ElektraInitiative/opensesame/doc/Battery.md

# Battery Module (Bat)

Checks the battery capacity every ten minutes and outputs to Nextcloud if it falls below 80%.
