ElektraInitiative/opensesame/doc/IRTemp.md

# IR Temp

This module implements the functions "ambient temperature" and "object temperature" of the [MOD-IR-TEMP](https://www.olimex.com/Products/Modules/Sensors/MOD-IR-TEMP/open-source-hardware) sensor.

## Config

Before using this module, you need to configure it with Elektra.
The following configurations are necessary:
`[ir/enable], [ir/device], and [ir/data/interval]`.
A description of these configuration parameters can be found in the file "opensesame.spec".
