ElektraInitiative/opensesame/doc/Audio.md

# Audio Module
This module handles audio output for playing fire alarms and bell sounds.
This module can receive commands from the Module Buttons (Bell), Environment (FireAlarm), Nextcloud (FireAlarm, Bell), and Signals (FireAlarm, Bell).
