ElektraInitiative/opensesame/doc/SUMMARY.md

# Summary

[README](../README.md)

# Development

- [Requirements](Requirements.md)
- [Emulating-Olimex](Emulating-Olimex.md)
- [DevelopmentSetup.md](DevelopmentSetup.md)
- [Translations](Translations.md)
- [Benchmark](Benchmark.md)
- [Debugging](Debugging.md)
- [Troubles libmodbus](libmodbus-troubles.md)
- [Troubleshooting](Troubleshooting.md)

# Using

- [Ansible](Ansible.md)
- [Installation](Install.md)

# Modules
- [Modules Overview](Modules_Overview.md)
- [GPIO](GPIO.md)
- [I2C](I2C.md)
- [MQ135](MQ135.md)
- [Garage](Garage.md)
- [Environment](Environment.md)
- [Front door](Haustüre.md)
- [Weather station](thiesclima-weatherstation.md)
- [Opensensemap](Opensensemap.md)
- [Inverter](goodwe-inverter.md)
- [Energy](Energy.md)
- [Audio](Audio.md)
- [Battery](Battery.md)
- [IR-Temp](ModIR.md)
- [Nextcloud](Nextcloud.md)
- [Ping](Ping.md)
- [Signals](Signals.md)
- [Error-Types](Types.md)
- [Watchdog](Watchdog.md)

# Usecases

- [Low Battery Warning](usecases/assigned/low_battery_warning.md)
- [Public Publishing of Weather Data](usecases/assigned/public_publishing_of_weather_data.md)
- [Warn on Indoor Temperatures](usecases/assigned/warn_on_indoor_temperatures.md)
