ElektraInitiative/opensesame/doc/Opensensemap.md

# Opensensemap
After you've setup your account and logged in on [opensensemap.org](https://www.opensensemap.org/), you need to do following steps:

## 1. Adding a senseBox

### 1.1 Naming Your Station
Choose a distinct name for your senseBox station.
### 1.2 Specifying Exposure
Select the appropriate exposure setting: indoor, outdoor, or mobile.
### 1.3 Geographical Coordinates
Enter the latitude and longitude or pick a location on the map.
### 1.4 Hardware Configuration
Choose the "Manual configuration" option under hardware.
This option is utilized for manually configuring the weather station's sensors.

## 2. Adding Sensors

### 2.1 Sensor Icon
Choose an icon to represent the weather phenomenon you're measuring.
### 2.2 Sensor Details 
- Obtain the sensor information from the [ documentation](https://www.thiesclima.com/db/dnl/4.92xx.x0.xxx_Clima_Sensor_US_e.pdf), focusing specifically on section `8.2.1 Measurement Values (Input Register)`.
- Extract the `Parameter Name` from the provided table and enter it in the `Phenomenon` input section.
- Retrieve the `Unit` from the table and input it into the `Unit` section.
- Identify the constant name in the [source code](../src/clima_sensor_us.rs) that corresponds to the register address of the row in the table, and input it into the `Type` section.

**Example:**

| **Registeraddress** | **Parameter name** | **Unit** | **Multiplier** | **Explanation** | **Data type** |
|---|---|---|---|---|---|
| 30003 0x7533 | Average wind speed | m/s | 10 | Value / 10 (to 1 decimal place, e.g. 101=10.1m/s) | U32 |
| 35005 0x88BD | Air temperature | °C | 10 | Value / 10 (to 1 decimal place, e.g. 255=25.5°C)  | S32 |

A constant within the [source code](../src/clima_sensor_us.rs) takes the form: `const REG_AIR_TEMP: u16 = 0x88BD;`

In this illustrative scenario, the variable `REG_AIR_TEMP` represents the air temperature.
Our initial action involves transferring the parameter designation `Air temperature` to the `Phenomenon` input section. Subsequently, we proceed to incorporate `°C` from the provided table into the `Unit` input section.
Finally, the variable name `REG_AIR_TEMP` is copied into the `Type` input field.

## 3. Obtaining IDs

### 3.1 senseBox-ID
Find the senseBox-ID in the `Dashboard` section.
### 3.2 Access-Token
Locate the Access-Token in `Dashboard/EDIT/Security`.
### 3.3 Sensor-IDs
Retrieve the Sensor-IDs from `Dashboard/EDIT/Sensors`.

## 4. Configuring Opensesame for Weatherstation Usage

### 4.1 Nextcloud Setup 
Configure Nextcloud as outlined in [DevelopmentSetup.md](./DevelopmentSetup.md).
### 4.2 Weather Station Configuration
Use the following commands in your terminal to configure Opensesame for your weather station:
```bash
kdb set user:/sw/libelektra/opensesame/#0/current/weatherstation/enable "1"
kdb set user:/sw/libelektra/opensesame/#0/current/weatherstation/opensensemap/id "<opensensemap-box-id>"
kdb set user:/sw/libelektra/opensesame/#0/current/weatherstation/opensensemap/token "<opensensemap-access-token>"
```
### 4.3 Enabling Sensor Mode
Enable sensor mode by creating a sensor profile with the following settings:
```bash
kdb set user:/sw/libelektra/opensesame/#0/current/sensors/#0/loc "Weatherstation"
```

Should the process of creating this array encounter any difficulties, the alternative course of action involves manually incorporating the configuration information into the `~/.config/opensesame.toml` file:
```bash
sensors."#0".loc = "Weatherstation"
```

### 4.4 Environment Name
Set an environment name using the command:
```bash
kdb set user:/sw/libelektra/opensesame/#0/current/environment/name "<any name>"
```
