ElektraInitiative/opensesame/doc/Energy.md

# Other Elektrical Devices

Snubber needs 0.25W (0.017A)

# Mod-IO

Standby 1.3W (0.038A)

count_errors script: 2.5W (0.012A)

# Miniatur Summer 93038C212A

5V, 23 mA
