ElektraInitiative/opensesame/doc/MQ135.md

# Calibration

Actually not needed for latest approach (which only detects differences).

08-05 05:00:13
RAW Values: 105 176 205 225 153 144 56 202 50 293 389 14
RZero: 76.08 63.47 56.39 89.90 96.50 272.99 388.51 307.65 39.39 25.77 5013.32
PPM: 391.56 428.74 389.12 552.21 535.39 649.78 1517.96 641.92 1359.00 1555.39 0.47
Env1: CO₂: 400 ppm, VOC: 0 ppb
Env2: CO₂: 400 ppm, VOC: 0 ppb

# SNS-MQ135

require 5V (±0.1)
Heater Resistance: 33Ω±5%
Heating consumption less than 800mw

measured for 12x SNS-MQ135: 8.9W
0.041A (41mA)

Related humidity less than 95%Rh

analog output is 0-5V
the digital output is frequency related to the output value¹ -> wrong
You can also use this sensor to get digital output from this pin, by setting a threshold value using the potentiometer.²

Note that when sensor are power up they need about 1 minute to settle, in this time the heater heats up the sensor. 

MQ-135 detects well Isopropile alcohol, Lighter gas

    400ppm – 750ppm: Good for health
    750 ppm – 1200 ppm: Take care
    1200 ppm (and above): Harmful to health³

# Possibilities to connect

ATmega16U4: 12-channels, 10-bit ADC
MOD-IO: 4-channels, 0-3.3V 10bit, needs 3.3V shifter
MOD-IO2: 4-channels (1, 2, 3, 5), also needs 3.3V shifter

# Arduino Micro

https://store.arduino.cc/products/arduino-micro
OR
OLIMEX OLIMEXINO-328 https://www.olimex.com/Products/Duino/AVR/OLIMEXINO-328/open-source-hardware

A0 connects
0V .. 0
5V .. 1023

typical output ~40 (37-44)
breath output ~60
```bash
screen /dev/ttyACM0 9600
```

## See also

¹ https://olimex.wordpress.com/2015/05/26/experimenting-with-gas-sensors-and-arduino/

² https://components101.com/sensors/mq135-gas-sensor-for-air-quality

³ https://www.codrey.com/electronic-circuits/how-to-use-mq-135-gas-sensor/

- doesn't work well (not all MQ135 sensors are suitable)
  https://hackaday.io/project/3475-sniffing-trinket/log/12363-mq135-arduino-library
