ElektraInitiative/opensesame/doc/Modules_Overview.md

# Modules Overview
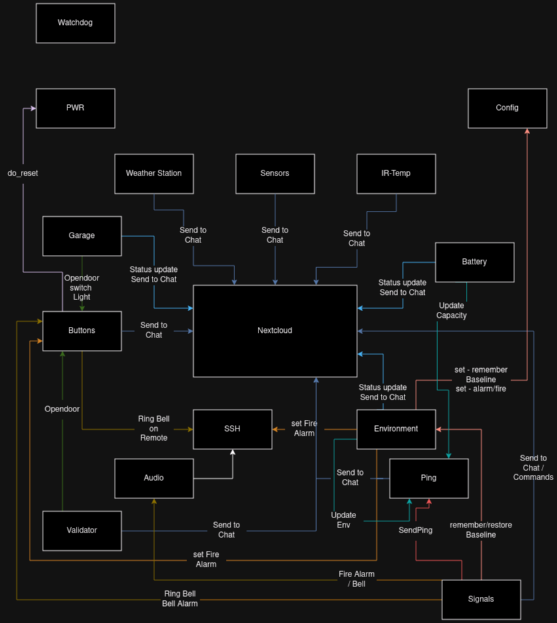
[picture p2: doc/images/information_flow_v0.8.0.png]
information_flow
