ElektraInitiative/opensesame/doc/goodwe-inverter.md

# Goodwe inverter
This documentation outlines the chosen steps for establishing communication with a goodwe-inverter. 
The hardware utilized for this communication includes an [A20-OLinuXino-LIME2](https://www.olimex.com/Products/OLinuXino/A20/A20-OLinuXino-LIME2/open-source-hardware) board with [LIME2-SHIELD](https://www.olimex.com/Products/OLinuXino/A20/LIME2-SHIELD/open-source-hardware) and a [MOD-RS485](https://www.olimex.com/Products/Modules/Interface/MOD-RS485/open-source-hardware) module. 

## important information
The `SLAVE_ID` by default `247`.
In the [doc](https://loxwiki.atlassian.net/wiki/spaces/LOX/pages/1605274474/Goodwe+GW10+ET+MODBUS+TCP+IP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) there is a list of all registers which can be read or written.

## wiring of the RS-485 connection
