ElektraInitiative/opensesame/doc/Benchmark.md

# Benchmark

## with opensesame v0.6.2

sensors: ~100ms per iteration (854ms first iteration)
haustuer: ~46ms per iteration (695ms first iteration)
garage:   ~46ms per iteration (710ms first iteration, 2620ms while compiling)
