ElektraInitiative/opensesame/(threads)

Thread 5 (2023-05-25):

opensesame.spec - configure Nextcloud

fel115, 2023-05-25:
How to setup the Nextcloud configuration in opensesame.spec.

- [x] - url
- [x] - chat; chat/licht; chat/ping
- [x] - user
- [x] - password

If these keys are not configured, this panic occurs:
`thread 'main' panicked at 'Did not find the key '/sw/libelektra/opensesame/#0/current/nextcloud/url'!', src/config.rs:121:13
stack backtrace:
   0: rust_begin_unwind
             at /rustc/84c898d65adf2f39a5a98507f1fe0ce10a2b8dbc/library/std/src/panicking.rs:579:5
   1: core::panicking::panic_fmt
             at /rustc/84c898d65adf2f39a5a98507f1fe0ce10a2b8dbc/library/core/src/panicking.rs:64:14
   2: opensesame::config::Config::get
             at ./src/config.rs:121:4
   3: opensesame::nextcloud::Nextcloud::new
             at ./src/nextcloud.rs:20:9
   4: opensesame::main
             at ./src/main.rs:187:26
   5: core::ops::function::FnOnce::call_once
             at /rustc/84c898d65adf2f39a5a98507f1fe0ce10a2b8dbc/library/core/src/ops/function.rs:250:5
note: Some details are omitted, run with `RUST_BACKTRACE=full` for a verbose backtrace.`

markus2330, 2023-05-25:
Thanks for reporting this issue! I agree this should be documented.

To get the "chat", you need to look at the URL when you are connected in the chat in the Nextcloud interface:

`https://nextcloud.markus-raab.org/nextcloud/index.php/call/<THIS IS THE TOKEN>`

markus2330, 2023-05-26:
You need the token (from the Nextcloud website) to write it in your configuration.

So first you visit https://nextcloud.markus-raab.org/nextcloud, do a login, navigate to the chat and copy the token from there to opensesame's config.

Please also document this.

fel115, 2023-05-26:
It looks like the URL doesn't exists:
`Couldn't ping 👋 Opensesame 0.7.6 init 2023-05-26T08:55:37.925376849+02:00 because https://nextcloud.markus-raab.org/ocs/v2.php/apps/spreed/api/v1/chat/vkgub94i: Client Error: 404 Not Found`

I created in Nextcloud a new conversation and then I copied the token, but for some reason the chat can't be found.

markus2330, 2023-05-28:
There is a misconfiguration in the base URL it should be https://nextcloud.markus-raab.org/nextcloud (you missed the /nextcloud). You can also easily test via curl:

`curl -sS -d "{\"token\": \"$CHAT\", \"message\": \"$*\"}" -H "Content-Type: application/json" -H "Accept: application/json" -H "OCS-APIRequest: true" -u "user:password" https://nextcloud.markus-raab.org/nextcloud/ocs/v2.php/apps/spreed/api/v1/chat/$CHAT`

Closed 2023-05-29.

Thread 6 (2023-05-25):

running opensesame causes panic with no information about the panic

fel115, 2023-05-25:
Running opensesame default, without configuring, the program abort with no further information. So there is no information about the problem.

`thread panicked while processing panic. aborting.
Abgebrochen (Speicherabzug geschrieben)`

markus2330, 2023-05-25:
Thanks for reporting the issue! Is this the problem you could solve by commenting out line 164 in src/main.rs (panic::set_hook)? Maybe we should add a configuration option for that.

fel115, 2023-05-25:
Yes. I am going to implement the CLIOptions module (https://crates.io/crates/clioptions). In case we need more CLIOption in the future.

markus2330, 2023-05-25:
Architectural changes should always be discussed in advance. We already use Elektra, which has support for command-line options: https://www.libelektra.org/tutorials/command-line-options but we shouldn't put time into this now.

Urgent now is that these beginners steps get documented, as they will be forgotten later.

Closed 2023-07-17.

Thread 7 (2023-05-25):

Remove AutoClose garage feature

markus2330, 2023-05-25:
Currently the garage door has an "automatically close later" feature by double pressing the button. This is, however, buggy, as it will also "automatically open later", which is quite surprisingly.

I think best is to completely remove that feature.

markus2330, 2023-06-06:
@fel115 this should be a quite easy feature to start with

fel115, 2023-06-09:
@markus2330  which button is pressed for this feature?

markus2330, 2023-06-09:
Everything related to GarageChange::AutoClose (double click on *_UNTEN*)

fel115, 2023-06-13:
Whats the difference between `taster_tor_oben` and `taster_tor_unten`, are these two taster, one for closing and the other for opening the door? And which would be for which case?

markus2330, 2023-06-14:
> Whats the difference between taster_tor_oben and taster_tor_unten, are these two taster, one for closing and the other for opening the door? And which would be for which case?

No, one of them is for lights, the other for the garage door. So there is only one button relevant for the garage door.

> So the other AutoClose feature is still needed, to close the door immediately?

No, the AutoClose feature can be removed completely. (AutoClose === double press garage feature) I renamed the issue to hopefully bring in more clarity.

> But if you click the button twice, the door is going to be closed 2 min after the button clicks.

This is exactly the behavior that should be removed. In the code it is called "AutoClose".

Please add test cases for the other features (normal opening and closing of garage door).

Closed 2023-07-17.

Thread 8 (2023-05-26):

simulate i2c device

fel115, 2023-05-26:
So I only need the Token ? Do I need to configure my nextcloud account?
Now I am getting this Error:

`Couldn't ping 👋 Opensesame 0.7.6 init 2023-05-25T19:44:20.353056793+02:00 because https://nextcloud.markus-raab.org/ocs/v2.php/apps/spreed/api/v1/chat/<THIS IS THE TOKEN>: Client Error: 404 Not Found
thread 'main' panicked at 'called `Result::unwrap()` on an `Err` value: Io(Os { code: 13, kind: PermissionDenied, message: "Keine Berechtigung" })', src/buttons.rs:132:65
stack backtrace:
   0: rust_begin_unwind
             at /rustc/84c898d65adf2f39a5a98507f1fe0ce10a2b8dbc/library/std/src/panicking.rs:579:5
   1: core::panicking::panic_fmt
             at /rustc/84c898d65adf2f39a5a98507f1fe0ce10a2b8dbc/library/core/src/panicking.rs:64:14
   2: core::result::unwrap_failed
             at /rustc/84c898d65adf2f39a5a98507f1fe0ce10a2b8dbc/library/core/src/result.rs:1750:5
   3: opensesame::buttons::Buttons::new
   4: opensesame::main
note: Some details are omitted, run with `RUST_BACKTRACE=full` for a verbose backtrace.`

_Originally posted by @fel115 in https://github.com/ElektraInitiative/opensesame/issues/5#issuecomment-1563300690_
    
As I backtraced this panic I recognised , that it isn't caused by Nextcloud instead it is caused by the button.rs LinuxI2CDevice. I think its because my devl-env has no `/dev/i2c-2` device. This could be solved by simulating the i2c device. Online I found the i2c-stub (https://www.kernel.org/doc/html/latest/i2c/i2c-stub.html), which cloud be the perfect tool.

markus2330, 2023-05-27:
Alternatively, and probably better for tests, is that you use the mocking from the i2c lib https://docs.rs/i2cdev/0.5.0/i2cdev/mock/struct.MockI2CDevice.html

But I wouldn't do that now, it is quite challenging from Rust point of view.

Closed 2023-10-15.

Thread 11 (2023-06-04):

Running opensesame against current development version of Elektra panics

atmaxinger, 2023-06-04:
So I have been trying to get opensesame running on the Olimex image.
I've compiled and installed the current `recording` branch of Elektra.

When I perform `cargo run` on opensesame, the following output is issued:

```
thread 'main' panicked at 'Set config failed: Sorry, module  issued error :
: ', src/config.rs:29:17
```

This is the backtrace:
```
stack backtrace:
   0: rust_begin_unwind
             at /rustc/90c541806f23a127002de5b4038be731ba1458ca/library/std/src/panicking.rs:578:5
   1: core::panicking::panic_fmt
             at /rustc/90c541806f23a127002de5b4038be731ba1458ca/library/core/src/panicking.rs:67:14
   2: opensesame::config::Config::sync
             at ./src/config.rs:29:5
   3: opensesame::config::Config::new
             at ./src/config.rs:20:3
   4: opensesame::main
             at ./src/main.rs:141:27
   5: core::ops::function::FnOnce::call_once
             at /rustc/90c541806f23a127002de5b4038be731ba1458ca/library/core/src/ops/function.rs:250:5
```

Any help on how to debug/solve this would be highly appreciated.

markus2330, 2023-06-04:
Did you already see https://github.com/ElektraInitiative/opensesame/pull/10/files?

Maybe @fel115 can help out, he went through similar problems recently.

Btw. as you see the error message is completely unhelpful, the parentKey is missing, and it actually should be **G**et config failed. To fix this first will probably help.

atmaxinger, 2023-06-05:
Yes, executing the postinst script manually solved this specific issue yesterday. However, there seems to be a bug somewhere, because I actually installed the `.deb` file built with `cargo deb`, and the script complains that it can't find the `kdb` executable. I think that might be caused by the `kdb` executable being installed in `/usr/local/bin` instead of `/usr/bin`.

Anyhow, executing the script `/var/lib/dpkg/info/opensesame.postinst` manually fixes this.

atmaxinger, 2023-06-05:
> (e.g. as Debian packages)

I have installed Elektra as Debian packages, I created them with the `make package` command. I'm not sure why it wants to install them to `/usr/local`.

markus2330, 2023-06-05:
It's the default from CMake, you need to set CMAKE_INSTALL_PREFIX=/usr to get proper packages.

markus2330, 2023-07-17:
Is this fixed now?

Thread 16 (2023-06-07):

TASTER_INNEN might lead to "Pressed 11" error

markus2330, 2023-06-07:
Probably due to "too fast release speed" of a switch, TASTER_INNEN might lead to "Pressed 11" errors.

```
src/main.rs:479: 🔘 Pressed 11 (bin: 1011)
```

Could be either a software bug (that handle src/buttons.rs 271 does not cope with a too fast state change) or a wrong handling of debouncing.

markus2330, 2023-06-07:
This problem is probably now much more apparent due to lower i2c speed introduced in 7018655756d7f1f1fedcff3ae2e3fcf581360f38

(But I don't think it was introduced by it.)

fel115, 2023-06-23:
How does `epins2.unwrap()` behave when a button is pressed? Does it return zero or one for the pressed button? Additionally, what is the purpose of `PINS2_INIT`? Does it activate the `LED_LIGHT` and `LED_BELL`?

Regarding `line 312` of the button.rs file, the comment states that pressed buttons are considered logical 0. Could you clarify whether this refers to the set pins or the return value? Why is it necessary for `pins2` to be smaller than the old `pins2` when the pressed button is zero?

fel115, 2023-06-26:
Ok so, the first 4 bits of the 8 bits of `pins2` indicate which button is pressed, and for a pressed button a bit is set to `0`.
I understand it now. Thank you!

markus2330, 2023-09-07:
This is a duplicate of #41

Closed 2023-09-07.

Thread 17 (2023-06-07):

i2c_2_clock_freq_overlay.dtbo not part of olinuxino-overlay

markus2330, 2023-06-07:
if `i2c_2_clock_freq_overlay.dtbo` is present in `/usr/lib/olinuxino-overlays/sun7i-a20` you get following error:

```
sudo olinuxino-overlay
`Error at 'compatible': FDT_ERR_NOTFOUND`
```
and `i2c_2_clock_freq_overlay.dtbo` cannot be selected in the list.

fel115, 2023-06-07:
I added the compatible and description attribute to the devicetree overlay, should I also add the sourcecode of the devicetree overlay to the project? If so in which folder should I add the sourcecode file?

markus2330, 2023-06-07:
Good point, yes of course, the source code should be added.

> If so in which folder should I add the sourcecode file?

Depends on number of files/size. If it is only one file, probably directly next to the binary file.

markus2330, 2023-06-07:
It is still not listed in `sudo olinuxino-overlay`, probably it filters based on the name (but I don't know).

fel115, 2023-06-09:
I analysed the `olinuxino-overlay`-script and I think the problem is, because I added in the following line a whitespace between the comma and sun7i-a20.
Changing this `compatible = "allwinner, sun7i-a20";` to `compatible = "allwinner,sun7i-a20";` cloud solve this issue.

fel115, 2023-07-17:
This issue is closed with the PR #29

Closed 2023-07-17.

Thread 28 (2023-07-17):

cli options for running opensesame

fel115, 2023-07-17:
Add command-line options to the OpenSesame project to allow disabling specific sections of the main program, such as the `panic::set_hook function`, which currently lacks informative panic details.

This idea of cli options was mentioned in this issue #6.

markus2330, 2023-07-17:
Better we talk about this. In any case it is not urgent, you can simply use normal Elektra config and `kdb set ...` to change config.

fel115, 2023-07-18:
Yes, I created this issue because I closed issue #6, so this information doesn't get lost.

Closed 2023-10-15.

Thread 32 (2023-07-18):

dependencies of opensesame package

markus2330, 2023-07-18:
What I did with the deb found in https://build.libelektra.org/blue/organizations/jenkins/opensesame/detail/PR-25/39/artifacts/

```
echo "deb [trusted=yes] https://thesis.maxirlinger.at/repo/ armhf/" > /etc/apt/sources.list.d/elektra-armhf.list && apt-get update
apt-get install -y --allow-unauthenticated libelektra-dev:armhf elektra-bin:armhf
dpkg -i opensesame_0.7.7_armhf.deb
```

What happened:
```
(Reading database ... 36751 files and directories currently installed.)
Preparing to unpack opensesame_0.7.7_armhf.deb ...
Unpacking opensesame (0.7.7) ...
Setting up opensesame (0.7.7) ...
Mount configuration
The command kdb spec-mount terminated unsuccessfully with the info:
No plugin that provides metadata check/length/max could be found
Please report the issue at https://issues.libelektra.org/
Mount state
Created symlink /etc/systemd/system/multi-user.target.wants/opensesame.service → /lib/systemd/system/opensesame.service.
```

I think we need some additional dependency next to elektra-bin in opensesame's package.

atmaxinger, 2023-07-18:
It seems to work with those new dependencies in PR #25

markus2330, 2023-07-18:
@atmaxinger thank you :heart:! Can we maybe move the length plugin to non-experimental for 0.11?

Closed 2023-07-18.

Thread 35 (2023-07-18):

Cargo test inside jenkins image

4ydan, 2023-07-18:
Cargo test inside the image used in jenkins would currently fail, due to missing ENV variables.
#25

Adding this to the Dockerfile or as env should fix it. Testet locally.

```
export PKG_CONFIG_PATH="/usr/lib/arm-linux-gnueabihf/pkgconfig"
export PKG_CONFIG_ALLOW_CROSS="true"
```

Closed 2023-08-09.

Thread 40 (2023-07-21):

PWR+watchdog might cause endless reboot loop

markus2330, 2023-07-21:
When pwr and watchdog is enabled, olimex might go in an endless reboot loop writing in the ping chat:

```
👋 Opensesame 0.7.7 init 20.07.2023 10:50:06
👋 PWR_SWITCH ausgeschalten
👋 Opensesame 0.7.7 init 20.07.2023 10:51:01
👋 PWR_SWITCH ausgeschalten
👋 Opensesame 0.7.7 init 20.07.2023 10:51:10
👋 PWR_SWITCH ausgeschalten
```

config:

```toml
debug.backtrace = "full"
debug.ping.enable = "1"
debug.ping.timeout = 24

pwr.enable = "1"
watchdog.enable = "1"
garage.enable = "0"
bell.enable = "1"
```

Workaorund: disable watchdog

markus2330, 2023-10-15:
Probably fixed now with 0.8, I'll reopen if it occurs again.

Closed 2023-10-15.

Thread 41 (2023-07-21):

ignore 11 press events

markus2330, 2023-07-21:
Due to electrical charges, e.g. during thunderstorms, single button presses may occur. Particularly, I noticed the button press event `11`:

```
Ein unbehebbarer Fehler ist bei src/main.rs:479: 🔘 Pressed 11 ... passiert
```

and:

```
Timeout mit Sequenz [0, 15, 0, 15, 0, 15]
```

For now this issue is only to collect such occurrences.

Maybe find an easy way to suppress such events.

Closed 2023-12-06.

Thread 42 (2023-07-22):

No metadata "mountpoint"

4ydan, 2023-07-22:
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
It's me again with another error. Not sure if I did something or something happened, so I will ask quick. It's the same setup as in #30, now I get this error when I want to run `postinst`.

markus2330, 2023-07-23:
Thx for asking. Most probably it somehow didn't mount the right file. What does `kdb mount` or `kdb file spec:/sw/libelektra/opensesame/#0/current` say?

fel115, 2023-07-24:
I think I had the same problem. And for solving the problem I executed `debian/postrm` and then again `debian/postinst`.

4ydan, 2023-07-24:
> What does `kdb mount`
```
[2023-07-24T19:37:11.798Z] + kdb mount
```
> or `kdb file spec:/sw/libelektra/opensesame/#0/current` say?
```
[2023-07-24T19:37:12.459Z] + kdb file spec:/sw/libelektra/opensesame/#0/current
[2023-07-24T19:37:12.459Z] /usr/share/elektra/specification/default.ecf
```

from [this](https://build.libelektra.org/blue/organizations/jenkins/opensesame/detail/PR-38/38/pipeline) pipeline inside stage `Test`

fel115, 2023-07-25:
I have no clue about the cause of this failure. However, based on the pipeline, we should modify the exit codes of the scripts to determine whether the job was successfully mounted or not.

markus2330, 2023-07-25:
> /usr/share/elektra/specification/default.ecf

`spec:/sw/libelektra/opensesame/#0/current` was not mounted at all

I'll have a closer look after the PermaplanT release.

markus2330, 2023-07-25:
> we should modify the exit codes of the scripts to determine whether the job was successfully mounted or not.

And also add a diagnostic `kdb mount` at the end.

markus2330, 2023-07-26:
"No metadata mountpoint" basically means that the whole spec file was not mounted correctly at its place.
(It is easy to see that files/opensesame.spec has a mountpoint at the very top, line 15).

I can reproduce, if I simply execute `./debian/postinst` in the `opensesame` folder I also get the same error. But if I enter the `debian` folder and execute `./postinst` it works for me. Maybe this is the problem?

Imho the correct way is anyway to install the package. Executing `./postinst` by hand is imho only a workaround for development.

fel115, 2023-07-27:
Maybe we could change the `postinst` script to be able to execute from any directory.

markus2330, 2023-07-27:
I don't think it is needed, as it is only a dev tool. Simply documenting how to use it in #10 imho should be enough.

Closed 2023-08-09.

Thread 47 (2023-07-29):

create circuit diagram

fel115, 2023-07-29:
Having a circuit diagram would make setting up the whole Opensesame system way easier. With a picture showing all the connections, you can put together the hardware setup much faster. The circuit diagram gives you a visual guide to understand how everything is connected, making the assembly process quicker and simpler. It's like a handy reference to ensure you're hooking up the hardware correctly, so you can avoid mistakes and get Opensesame up and running without a hitch.

fel115, 2023-07-29:
@markus2330, perhaps you could provide me with some pictures of the A20-Lime2 board and the MOD-IO2. With that, I can create the diagram.

markus2330, 2023-07-29:
This is a great idea and I would like to have it. Unfortunately, it is out of scope for the current work, we are already quite behind the schedule to implement everything in TODO. This is, however, definitely within scope for Netidee!

Closed 2023-10-19.

Thread 51 (2023-08-03):

I2C Communication to Buttons does not work: Nix(ENXIO)

fel115, 2023-08-03:
Testing opensesame on a board without the MOD-IO2 module causes the following Error.

```bash
thread 'main' panicked at 'I2C Communication to Buttons does not work: Nix(ENXIO)', src/buttons.rs:142:14
stack backtrace:
   0: rust_begin_unwind
             at /rustc/d5a82bbd26e1ad8b7401f6a718a9c57c96905483/library/std/src/panicking.rs:575:5
   1: core::panicking::panic_fmt
             at /rustc/d5a82bbd26e1ad8b7401f6a718a9c57c96905483/library/core/src/panicking.rs:64:14
   2: core::result::unwrap_failed
             at /rustc/d5a82bbd26e1ad8b7401f6a718a9c57c96905483/library/core/src/result.rs:1791:5
   3: core::result::Result<T,E>::expect
             at /rustc/d5a82bbd26e1ad8b7401f6a718a9c57c96905483/library/core/src/result.rs:1070:23
   4: opensesame::buttons::Buttons::init
             at ./src/buttons.rs:140:3
   5: opensesame::buttons::Buttons::new
             at ./src/buttons.rs:135:3
   6: opensesame::main
             at ./src/main.rs:296:20
   7: core::ops::function::FnOnce::call_once
             at /rustc/d5a82bbd26e1ad8b7401f6a718a9c57c96905483/library/core/src/ops/function.rs:507:5
note: Some details are omitted, run with `RUST_BACKTRACE=full` for a verbose backtrace.
```
Maybe we should set some variables to enable and disable modules in opensesame. As I have seen `buttons` is widely used in the source, so it's hard to disable it without causing other errors.

markus2330, 2023-08-03:
It is already possible to disable some modules. Disabling the buttons is currently only possible by enabling sensors, which --- I agree --- is a weird hack. When we introduce more and more Tokio, we can also create smaller modules.

But: we should keep the current uniform way of using Elektra's configs `<module>/enable` to enable modules. We can use environment variables and command-line arguments also via Elektra, maybe @flo91 will work on that.  #28

markus2330, 2023-08-04:
> How do I enable sensors?

spec and code should give such answers :wink:

fel115, 2023-08-04:
> > How do I enable sensors?
>
> spec and code should give such answers 😉

Ahhh eh

markus2330, 2023-08-04:
I created /home/olimex/.config/opensesame.toml using Ansible, can you please add the additional config needed for the weatherstation?  (sensor mode is already active)

markus2330, 2023-08-04:
I get this error above even if `user:/sw/libelektra/opensesame/#0/current/sensors/#0/loc` is present.

Seems like there is some regression.

markus2330, 2023-10-15:
Seems to be fixed now.

Closed 2023-10-15.

Thread 58 (2023-08-15):

Implementation of MOD-BME280

fel115, 2023-08-15:
The aim of these issues is to exchange the [MOD-ENV](https://www.olimex.com/Products/Modules/Sensors/MOD-ENV/open-source-hardware) module with [MOD-BME280](https://www.olimex.com/Products/Modules/Sensors/MOD-BME280/open-source-hardware). The difference between these two modules is, that the [MOD-ENV](https://www.olimex.com/Products/Modules/Sensors/MOD-ENV/open-source-hardware) is also able to measure the air quality.

fel115, 2023-08-15:
@markus2330, based on my understanding, it seems that we need to modify the 'environment.rs' file to enable configuration specifically for using theMOD- BME280. This adjustment is necessary because the MOD-ENV includes both the BME280 and an additional CO2 sensor.

fel115, 2023-08-15:
@markus2330 what's the difference between "environment.rs" and "sensors.rs"? What sensors are connected over the '/dev/ttyACM0'? Is there external hardware with sensors connected which are sending the sensor data over this serial connection?

Would it be better to create a handler in which it is possible to enable env-sensors and the other sensors explicitly?

fel115, 2023-08-16:
OK, then I would create a new Module for MOD-BME and the MOD-IR-TEMP for returning temperature, pressure, and humidity. So the new module can be used in the main loop if it is configured.

Closed 2023-12-04.

Thread 62 (2023-08-16):

Implementation of MOD-IR-TEMP in new module

fel115, 2023-08-16:
**Create a new Module with the following functions**
- [x] read object temperature
- [x] read ambient temperature

markus2330, 2023-08-21:
Thank you for creating the issue! I don't think we actually need the raw IR measurement.

Closed 2023-09-04.

Thread 64 (2023-08-18):

spelling fixes

markus2330, 2023-08-18:
Let us use some spell checker. In PermaplanT we have in .pre-commit-config.yaml:

```
  - repo: https://github.com/codespell-project/codespell
    rev: v2.2.4
    hooks:
      - id: codespell
        # Scan all .md files, exclude folders /meetings & /reports.
        files: ^(?!.*\/(meetings|reports)\/).*\.md$
        args: [-L crate]
        stages: [manual]
```

markus2330, 2023-10-15:
please do at least one manual run

Closed 2023-10-20.

Thread 70 (2023-08-21):

Env - Configurable corrections on Temperature

fel115, 2023-08-21:
@markus2330 what is meant by this task? Which correction? Something like a closed-loop controller?

markus2330, 2023-08-22:
It is simply a correction value to be added/removed to adjust/calibrate the temperature. The user only should see the corrected value.

fel115, 2023-08-22:
So the configurable correction could be `-0.4°C` and the sensor temp `26.8°C`, then should the user see `26.4°C` as a result?

markus2330, 2023-08-22:
Exactly. This is useful as the MOD-ENV are quite inaccurate. I didn't check MOD-IR yet (compare with high-precision thermometer) but probably something similar is useful there, too.

fel115, 2023-08-23:
According to the [data-sheet](https://www.olimex.com/Products/Modules/Sensors/MOD-IR-TEMP/resources/MLX90614_rev001.pdf) the MOD-IR has a high accuracy. `High accuracy of 0.5°C over wide temperature
range (0..+50°C for both Ta and To)`.

Should I create a new PR for this issue, after #63 is merged?

markus2330, 2023-08-24:
Not high-prior, let us do the refactoring first.

markus2330, 2023-08-24:
Not high-prior, let us do the refactoring first.

markus2330, 2023-10-14:
@fel115 do you already have a fix for this?

fel115, 2023-10-18:
Not implemented now

Closed 2023-10-19.

Thread 71 (2023-08-21):

Env - warn on fast raising values, next to MQ135 (temperature, CO2, VOC, Pressure)

fel115, 2023-08-21:
@markus2330 How is the MQ135 connected via the `/dev/ttyACM0`? And where should this function be implemented, in the environment.rs or mod_ir_temp.rs?

markus2330, 2023-08-22:
For MQ135 it is already implemented, see src/sensors.rs line 154. The idea is to do the same for mod-env and mod-ir.

The idea is to warn on very fast changing values, which could be caused by direct sunshine or also fire.

fel115, 2023-08-23:
Ok, this needs to be implemented for MOD-IR-TEMP and MOD-ENV. Is it a requirement to use the Exponential Moving Average?

markus2330, 2023-10-14:
@fel115 do you already have a fix for this?

fel115, 2023-10-18:
Not implemented now

Closed 2023-10-19.

Thread 72 (2023-08-21):

Env - temperature alarm e.g. 50° (check max temp from sensor) and warning e.g. 28° (window left open)

fel115, 2023-08-21:
@markus2330 Should this function be set in the main.rs? Is the `window left open` function already implemented?

fel115, 2023-08-21:
removed from TODO in PR #65

Closed 2023-08-21.

Thread 74 (2023-08-23):

Architectural changes: Tokio + Modules

horenso, 2023-08-23:
This issue is to keep track of the architectual changes in main and the restructure of the system into "modules", which work independenly of each other.

@fel115 and myself identified the following functunality (work in progress, I'm just dumping them here)

- [ ] Config (libelektra)
- [ ] Nextcloud (bidirectonal status and commands, reusing http client/connections)
- [ ] Weather Station
- [ ] Sensor (has fire alarm)
- [ ] Buttons (MOD-IO2)
- [ ] Validator
- [ ] Garage / Door / Light
- [ ] Bat (battery supply and warning about battery mode)
- [ ] Watchdog
- [ ] PWR
- [ ] Environment (MOD-ENV)
- [ ] SSH / Other way of distributed communication

At the moment, there are two independet loops in main, "sensor mode" and "normal mode". To reason about the current architecture more clearly we refactored it (https://github.com/horenso/opensesame/blob/refactor_main/src/main.rs) into diffenent methods, without changing the semantics. This is helpful to see what parts are actually used in which loop.

The next step is to identify all blocking calls and research alternatives. For sure, all file operations (like `lines()`) must be replaced with async methods (like `tokio::fs`).

Modules can be enabled/disabled. Some things above (like config) are global whereas Nextcloud, Button and Sensors should become modules. More details about the exact interfaces follow.

markus2330, 2023-08-24:
Thank you for creating this issue!

> following functunality

I added `-  [ ]` so that you can track progress by clicking on the items. I also prioritized them, in which order I would like to test (weather station + sensors first).

> (MOD-IO2, has fire alarm)

What do you mean with that? Sensor does not need MOD-IO2.

> This is helpful to see what parts are actually used in which loop.

I am not sure if we are on the same page: these two loops are arbitrary and don't have any relevance. Any module should work together with any other module, there shouldn't be a normal or sensor mode. Sensors should be a normal module like any other.

> The next step is to identify all blocking calls and research alternatives.

First the interfaces.

It is important that we have intermediate steps every day, so that we soon can start testing. Let us first get weather station+sensors running on the new architecture (the file writes done in the sensor loop can be dropped, they are not important).

> Modules can be enabled/disabled.

:+1:

> Some things above (like config) are global whereas Nextcloud, Button and Sensors should become modules.

Nextcloud in general also needs to be global. Ping could be a module.

> More details about the exact interfaces follow.

Looking forward to :rocket:

horenso, 2023-08-27:
Thanks for the comments!

> What do you mean with that? Sensor does not need MOD-IO2.

What is the MOD-IO2 needed for? I don't have a clear picture about all the hardware involved yet.

> I am not sure if we are on the same page: these two loops are arbitrary and don't have any relevance. Any module should work together with any other module, there shouldn't be a normal or sensor mode. Sensors should be a normal module like any other.

We're on the same page, this refactor was just to assess how the program works right now. Of course there will only be one event loop with different capabilities, that can be enabled and disabled.

> It is important that we have intermediate steps every day, so that we soon can start testing. Let us first get weather station+sensors running on the new architecture (the file writes done in the sensor loop can be dropped, they are not important).

Good idea. I'll make a PR soon with the first step.

markus2330, 2023-08-27:
> What is the MOD-IO2 needed for?

Currently only for the "buttons" module.

>  I'll make a PR soon with the first step.

:rocket:

markus2330, 2023-10-15:
All seems to be done now.

Closed 2023-10-15.

Thread 77 (2023-08-29):

Docu: Async Architecture and Interfaces

fel115, 2023-08-29:
# Async Architecture
The following modules can be disabled through elektra config.
- bat.rs
- buttons.rs + garage.rs
- clima_sensor_us.rs
- environment.rs
- garage.rs
- mod_ir_temp.rs
- pwr.rs
- sensors.rs
- ssh.rs
- validator.rs
- watchdog.rs

`config.rs` and `nextcloud.rs` are the minimal modules, which are needed for running Opensesame. Or should it be possible to replace `nextcloud` with an std-output?

# Module Interfaces
## 1. Enable checked by modules
### 1.1. new(config) -> Self;
This function returns a new object of the struct. According to the config in elektra it returns an default object or a object with all data like 'libmodbus' connection, 'i2c' connection.
### 1.2. All pub functions need to check if this object is enabled or disabled, with a variable in the struct.
If a module is disabled it returns an error code that indicates that the module is disabled.
## 2. Enable checked by async loop
### 2.1. new(config) -> Self; and new_default() -> Self;
These two functions are needed because if a module is disabled the main loop calls `new_default() -> Self` to get a default object, so the variable in `main` is not uninitialized. The variable is overwritten with ` new(config) -> Self` if the module is enabled. So it would be possible to enable and disable modules during runtime.
### 2.2 Main function
In the `main`, it would be only if conditions for every module.

horenso, 2023-08-29:
2.1. Why don't we keep a collection of modules (Like a `Vec<dyn Module>` or something like that)? That seems better than having dummy objects.

I imagine it something like this:

```rust
use tokio::io::{self, AsyncBufReadExt};

pub async fn read_device_file(device: &str) {
    let file = tokio::fs::File::open(device).await.unwrap();
    let reader = io::BufReader::new(file);

    let mut lines = reader.lines();
    while let Some(line) = lines.next_line().await.unwrap() {
        println!("Read from device: {}", line);
    }
}
```

and then in main:

```rust
#[tokio::main]
async fn main() {
    ...

    if condition_1 {
        tokio::spawn(module1::read_device_file("/dev/test1"));
    }

    if condition_2 {
        tokio::spawn(module1::read_device_file("/dev/test2"));
    }

    loop {
        // here we listen to config/nextcloud changes
    }
}
```

Note that we don't have to have a dynamic approach, meaning that you cannot enable a disabled module without restarting.

horenso, 2023-08-29:
I think the two challenges are:
1. How can we have clean error handling?
2. How can we share a module like Nextcloud? I suppose we need to work with `Mutex`s so that Nextcloud should ask a `state` variable that is owned by the module.

fel115, 2023-08-29:
> 1\. How can we have clean error handling?

I thought about something like that:
```rust
pub enum Error<E> {
    I2C(E),
    MODBUS(E),
    DISABLED,
    ...
}
```
> 2\. How can we share a module like Nextcloud? I suppose we need to work with `Mutex`s so that Nextcloud should ask a `state` variable that is owned by the module.

Do we need to share the Nextcloud module? We could create a Nextcloud object for every module or is that problematic?

3. What we also need to think of is, that many modules use timeouts that depend on the main-loop, because the main-loop sleeps for 10ms every duration. So if a timeout is set to `1000` it means 10 seconds. If we don't have any sleep we need to manage this differently.

markus2330, 2023-08-29:
Next steps:

- create a PR where the interface is described in (pseudo) Rust code.
- ask further questions here as needed

> config.rs and nextcloud.rs are the minimal modules, which are needed for running Opensesame. Or should it be possible to replace nextcloud with an std-output?

If nextcloud fails to send, there is a message to stderr anyway. Having exchangeable modules for different chats is out-of-scope.

>new(config) -> Self;

We need a description in which situations it is allowed to fail. I think it should always succeed, even if it is totally broken. Then the object simply disables itself.

> If a module is disabled it returns an error code that indicates that the module is disabled.

How does it return the error code?

> These two functions are needed because if a module is disabled the main loop calls new_default() -> Self to get a default object, so the variable in main is not uninitialized.

I think it is more pretty if all of this happens within `new(config) -> Self`? So if it is disabled, a default Self doing nothing is returned.

> In the main, it would be only if conditions for every module.

I don't understand the sentence.

> With Tokio we can also just spawn threads for each module.

We should avoid that. Spawning a thread for a module is only last resort if everything else fails. Functional better is an architecture where tasks are delegated to a thread pool  (needing less resources as it spawns less threads, ideally only a thread per CPU).

> Note that we don't have to have a dynamic approach, meaning that you cannot enable a disabled module without restarting.

What can happen is that at runtime a module fails and it needs to be disabled as the error is permanent. (To not get errors for each time calling `handle()`.)

> How can we have clean error handling?

Yes, this is an important topic.

> How can we share a module like Nextcloud? I suppose we need to work with Mutexs so that Nextcloud should ask a state variable that is owned by the module.

The imho prettiest solution is that modules provide means to tell that something should be communicated and main or a dispatcher forwards this information to Nextcloud. Then the modules would not know anything about Nextcloud. This is also currently the case.

Easier/more flexible for modules is probably what you suggest. I am okay with both.

The big question is how you want to solve the incoming chat messages.

> Do we need to share the Nextcloud module? We could create a Nextcloud object for every module or is that problematic?

Yes, it is problematic, as then you would have N connections to Nextcloud. Ideally you would only have one (or one per thread if you don't want mutex at all).

>  What we also need to think of is, that many modules use timeouts that depend on the main-loop, because the main-loop sleeps for 10ms every duration. So if a timeout is set to 1000 it means 10 seconds.

This 10ms raster was only a hack for not having proper scheduling of tasks. It is better if either

- we hardcode how often which module gets called. So if the module only needs to be called every second, it also only gets called every second (and not 100 times, ignoring 99 times).
- modules tell when they should be called again (a bit more flexible but might be also more complicated. The current code does not necessarily need it. In some cases it would have been nice to have, e.g. for buttons you typically want every 10ms but for relay switching 10ms is too fast).

fel115, 2023-08-29:
Issue # #74

markus2330, 2023-08-30:
> But how does the calling function then know, what has happened? So the user would think the module is loaded but it isn't.

I thought that there is some `status()` function that tells the framework if a module is disabled.

> I meant that only the main loop checks if an object of the modules should be created.

I think it is simpler if modules decide this internally. There might be more tricky situations of disabling which imho belong to the module and not to main.

> So do you mean, that we have a thread per module, but the module-threads are added to a pool, where they are executed one by one?

No, there is only the main thread and a thread pool, empty when starting. The main thread is doing the tokio mainloop and the thread pool executes longer tasks to never block the mainloop (if needed). The modules don't have threads on their own but their tasks get assigned to any of the threads in the pool.

Probably an existing thread pool implementation should be used, in a quick search I found:

- https://docs.rs/rayon/1.3.0/rayon/struct.ThreadPool.html
- https://docs.rs/tokio-threadpool/latest/tokio_threadpool/

@fel115 please have a better look at options available, write a decision about that. You might be able to use this research in your thesis. E.g. see https://www.usenix.org/conference/atc20/presentation/boucher (only meant as hint for your thesis, I don't propose that we use this in Opensesame).

>  Is it possible for the modules to add their messages to a queue? So the modules can't overwrite the content of other modules? Or doesn't it work because of the borrowing of the nextcloud object?

Is this question to me or @horenso? What did you find out so far?

> So I think it would be easy to ask the server for new messages every few times. And for that async isn't necessary. You only need to save the ID of the last read message and then you are able to collect all new messages.

The http requests with lookIntoFuture might take up to 60 seconds until you get an answer. So working async there makes sense that there doesn't need to be a dedicated thread waiting so long.

horenso, 2023-08-30:
> We should avoid that. Spawning a thread for a module is only last resort if everything else fails. Functional better is an architecture where tasks are delegated to a thread pool (needing less resources as it spawns less threads, ideally only a thread per CPU).

When you use
```
#[tokio::main]
async fn main() -> io::Result<()> {
```

tokio starts a runtime with as many worker threads as there are cores on a CPU. `tokio::spawn` spawns lightweight, green threads, that are managed by the runtime and are mapped to actual OS threads.

markus2330, 2023-08-30:
> tokio starts a runtime with as many worker threads as there are cores on a CPU

This is exactly what we want.

> tokio::spawn spawns lightweight, green threads, that are managed by the runtime and are mapped to actual OS threads.

If used correctly, this is then harmless and such a green thread could be used for each module, if needed.

> I have a question about the signals @markus2330 are any of the signals neccessary, or where they just a hack because of no event loop? Is the program required to respond to any signals? (I mean apart from SIGINT, like the user signals or SIGALRM).

- SIGUSR2 and SIGALRM are actually used in application logic (triggered via ssh).
- SIGHUP is used by Elektra via files/reload-opensesame. files/reload-opensesame could be changed to completely restart opensesame instead.
- SIGUSR1 is a useless feature, can be deleted

Please add documentation for that.

> For communication between modules we'd like to use mpsc::channel.

:+1: sounds good to me.

> We drew a diagram that starts to outline the current architecture.

Thx for drawing it, looks great. Please keep updated.

horenso, 2023-08-31:
Here is our next iteration (still WIP)

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

fel115, 2023-09-03:
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

I created a new draw.io and described the information flow between the Modules. The only connection I didn't draw, is the read connection to the config-Module because every Module does this and I haven't had enough space :sweat_smile:

fel115, 2023-09-04:
According to the issue with the weather station, I found an async implementation of [Modbus](https://github.com/slowtec/tokio-modbus) and the problem with setting the pins for reading and writing could be managed by the Linux system https://github.com/slowtec/tokio-modbus/issues/182

horenso, 2023-09-05:
> I found an async implementation of [Modbus](https://github.com/slowtec/tokio-modbus)

That looks very promising!

markus2330, 2023-10-15:
Seems all is done now! :heart:

Info here should be moved to docu now.

Closed 2023-10-19.

Thread 78 (2023-08-30):

GPIO Pins Garage

fel115, 2023-08-30:
># GPIO Input
>## Layout Platine
>  Taster Eingang Oben -> Pin40 GPIO234 EINT10
    Taster Eingang Unten -> Pin38 GPIO235 EINT11
    Taster Tor Oben -> Pin36 GPIO236 EINT12
    Taster Tor Unten -> Pin32 GPIO237 EINT13
    Schalter Garagentor Endposition -> Pin26 GPIO238 EINT14

Is this right? On which connector should this connection be? As I searched the [datasheet](https://www.olimex.com/Products/SOM/A20/_resources/A20-Brief-2013-02-27.pdf) I found `EINT10` on `PH10` which is `GPIO234` on the olimex board. But I found it in the [Lime2-datasheet](https://www.olimex.com/Products/OLinuXino/A20/A20-OLinuXino-LIME2/resources/A20-OLinuXino-LIME2-UM.pdf) at `GPIO-3` on `Pin13` and not `Pin10`. I am a bit confused.

markus2330, 2023-08-30:
It is with the large GPIO5 connector of LIME2-SHIELD. Please look there how it is connected and update documentation.

fel115, 2023-08-30:
Oh thanks, know it makes sense. On the olimex board  it is `GPIO-3 Pin10`.

Closed 2023-08-30.

Thread 80 (2023-08-31):

Garage door endposition

fel115, 2023-08-31:
Is the garage door open if the endposition switch is reached or closed?  Because the status says `Closed` and the message says `Garage door closed.`.

https://github.com/ElektraInitiative/opensesame/blob/5ede5a8dc4a27e5cd733353df23f727fd7485a8e/src/main.rs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

markus2330, 2023-08-31:
The garage door is closed if the endpoint switch is closed.

You found a bug, great job! :heart: :rocket:

Both the set_info_door text (but not the symbol) is wrong.

markus2330, 2023-10-15:
Maybe you already fixed it but I cannot check due to #106

fel115, 2023-10-16:
should be fixed with PR #112

Closed 2023-10-20.

Thread 81 (2023-08-31):

document pull-up for Garage

fel115, 2023-08-31:
What does it change, if I set the GPIO3 of the MOD-IO2 board to 5V? And setting 5V on the GPIO-Pin might be to much?

https://github.com/ElektraInitiative/opensesame/blob/5ede5a8dc4a27e5cd733353df23f727fd7485a8e/doc/Garage.md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

Also is it possible to use the `garage module` with the `buttons module`?
 If I enable garage it is doing some weird stuff.
E.g. switching of relays and the buttons can't be pressed. Is there a relation to the 5V on GPIO3?
If a `Taster` of the garage module is pressed, does it set the connected GPIO-Pin to GND?

fel115, 2023-08-31:
Ok now I connected Leds to the GPIO-Pins, and only the `Taster Eingang Oben` and `Taster Eingang Unten` seem to have a pull-up. But I have no idea how these are configured as pull-up inputs :thinking:

fel115, 2023-09-01:
Now I tested it with external pull-ups and it is working. So maybe the Lim2-Shield pulls the input pin up ?

markus2330, 2023-09-01:
>  Is it possible to use the 3.3V?

For input pins with the right 3.3V (from the board itself) it should be possible but pull-ing up with a switch to ground ground is simpler/safer.

> Which size should be the pull-up resistor 47k?

Yeah, iirc I always used 47kΩ. Smaller values should also work but they need more energy. For larger values you need to test for yourself if it provides stable results.

>  Is the GPIO-Pin automatically a pull-up input, if it's configured as input?

There are big tables in the Internet/Olimex forum that tell the default configuration for each pin.

> Now I tested it with external pull-ups and it is working.

Great!

> So maybe the Lim2-Shield pulls the input pin up ?

I don't think so. More likely I forgot to document that a 47kΩ pull-up is needed.

markus2330, 2023-10-15:
Is docu updated about that pull-up?

fel115, 2023-10-16:
Done in PR #115

Closed 2023-10-19.

Thread 82 (2023-09-04):

async weather station

markus2330, 2023-09-04:
> According to the issue with the weather station, I found an async implementation of [Modbus](https://github.com/slowtec/tokio-modbus) and the problem with setting the pins for reading and writing could be managed by the Linux system https://github.com/slowtec/tokio-modbus/issues/182

_Originally posted by @fel115 in https://github.com/ElektraInitiative/opensesame/issues/77#issuecomment-1704944903_

markus2330, 2023-09-04:
(I took this discussion away from #77 as we decided to do this after buttons)

@fel115 this sounds promising.

I assume using this module is nearly a rewrite of modbus related code?

Do you know what they mean with "the RS-485 feature of the serial"?
Is this via implementing a Linux driver?

fel115, 2023-09-04:
Yes, but I think it wouldn't be that much, because we only read the registers and that is one function.

Yes, I think we can set the pins for the ioctl calls in the system, so we don't need a custom function like in libmodbus-rs. But I haven't done further research.

fel115, 2023-09-10:
[This](https://github.com/slowtec/tokio-modbus/issues/127) cloud also be an idea. The problem is that the pins on the lime2-shield don't forward the Uart connections' RTS-Pins.

markus2330, 2023-10-15:
Seems to be done! :heart:

Closed 2023-10-15.

Thread 83 (2023-09-07):

sensors: ignore individual measurements above treshhold

markus2330, 2023-09-07:
unfortunately there are some glitches in the analog/digital converter, which needs some post-processing.

The sensor module should not trigger immediately if a single measurement is across a threshold. Furthermore it should not immediately forget about its state when a single measurement is below a threshold.

I now connected a Pt100 sensor with the sensors module, which works (except of this bug) great. Here the temperature measurements of the last days:

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

You can easily spot the individual spots, which imho shouldn't have lead to a warning.

Thread 85 (2023-09-07):

weather station: uploads sometimes broken

markus2330, 2023-09-07:
Nearly every day there are warnings like:

```
https://api.opensensemap.org/boxes/64cb602193c69500072a580f/data: timed out
https://api.opensensemap.org/boxes/64cb602193c69500072a580f/data: Server Error: 502 Bad Gateway
```

Most of the time it is 502 Bad Gateway.

I hope this can improve with the async framework, can we maybe try again a few times? (retrying must end within a minute though, as then there is already new data and we don't want to spam the server if it has capacity issues.)

horenso, 2023-09-11:
How frequent is the communication to/from the weather station?

fel115, 2023-09-11:
The weatherstation updates every minute.

Closed 2023-12-04.

Thread 92 (2023-10-03):

Seperate Validator- and Buttons-Modul

fel115, 2023-10-03:
Now the Validation of an input is done in the `get_background_task` of the Buttons module. And the idea is, that validation only needs to be checked if a Pin-Button was pressed. There could be a channel between Buttons and the Validator, and the Buttons module sends every new sequence to the Validator module. The validator module also needs to send commands to the Buttons module to `show_wrong_input`, `ring_bell`, `open_door` and `switch_lights`.

The handling of `Timeout` and `SequenceTooLong` might be tricky or need a new structure for the validation. Special Commands for that can be created on Buttons side.

markus2330, 2023-10-15:
I don't think this is needed.

Closed 2023-10-15.

Thread 93 (2023-10-03):

Overthink Channel receive of Environment

fel115, 2023-10-03:
The problem is, that if the Environment loop is only called every minute, so it can only receive MPSC-Channel messages every minute. So if we need to RestoreBaseline we need to wait a max of one minute to RestoreBaseline. The idea is to use two loops, one for handling the Envirionment data and one for receiving the MPSC-Messages. But RememberBasline and RestoreBaseline need to know the new data gathered by the other loop. Maybe a communication between the loops? Or Maybe using `tokio::macros::select` to execute the path which is triggered.

markus2330, 2023-10-07:
Thank you for creating this issue!

> "So if we need to RestoreBaseline"

Do you mean in the case of signals?

fel115, 2023-10-08:
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

Yes, especially in case of signals. Here the program should terminate fast and save all data.

markus2330, 2023-10-08:
Why not make an explicit additional saving when the program terminates independent of these loops?

fel115, 2023-10-08:
Yes, this was another idea, to use a Mutex of Environment and do the restore in the signals module.

markus2330, 2023-10-09:
Buttons already implements Drop, which also should be executed on shutdown. The same technique could be used for the sensors module.

I don't think that the signals module should know anything from the other modules.

fel115, 2023-10-09:
> Buttons already implements Drop, which also should be executed on shutdown. The same technique could be used for the sensors module.

Do you mean the Environment module? So we store the baseline in the Drop function.

> I don't think that the signals module should know anything from the other modules.

So the signals shouldn't have a channel to the modules? Or do you mean the mutex shouldn't be passed to the signals module?

markus2330, 2023-10-09:
>  Do you mean the Environment module? So we store the baseline in the Drop function.

Yes, exactly :rocket:

> So the signals shouldn't have a channel to the modules? Or do you mean the mutex shouldn't be passed to the signals module?

I meant that the signals should not have a reference to the Environment (or any other module), thus they should be unable to store the baseline.

Can you please update the architecture picture? Dependencies like this should be visible, as they are important.

markus2330, 2023-10-15:
Doesn't seem to be fixed?

Thread 98 (2023-10-12):

Refactroing of nextcloud code

fel115, 2023-10-12:
https://github.com/ElektraInitiative/opensesame/pull/75#discussion_r1341676850

Refactor the Nextcloud Commands loop.

horenso, 2023-10-21:
I'm working on the config of the PIN in the nextcloud loop. Do we refactor the config to have the mutex in the config?
I want to set the PIN code via Nextcloud, I could do the same as in Signals where Nextcloud takes a `Arc<Mutex<Config<'a>>>`
and then we refactor the Mutex in Config afterwards, or should we do this before? @fel115

fel115, 2023-10-21:
I think it would be better to refactor the config before as we have problems with the execution of `config.sync()` in the signals module. We always get a panic, by executing the sync function in the signals module.

Maybe we could also use a get_background_task for config. So we don't need to use mutex and remember/restore baseline (env), set alarm and set pin can be handled by this function. By this method we only  need to get the environment data to the config file to restore baseline.

markus2330, 2023-10-22:
Changing of PIN is only one of many commands and not the most important one, so please implement the other commands properly first (refactor the code that implements the commands).

I updated the full list of commands in the use case #125. But the system should be flexible and new commands should be easy to add.

Thread 104 (2023-10-15):

too noisy when starting

markus2330, 2023-10-15:
Current behavior, I get following 4 messages to the main chat:

```
Nextcloud stated...
15:47
Started listening to commands here
15:47
Enabled Modules:
Buttons: false
, Garage: false
, Sensors: true
, ModIR: false
, Environment: false
, Weatherstation: true
, Battery: true
, Watchdog: true
15:47
🔋 Battery Capacity is back to 100%
15:47
```

Wanted behavior:

1. Version number should be included
2. Only one message (suppress "Nextcloud stated." and "Battery Capacity is back to 100%")
3. startup messages should go to ping, as it is not interesting for normal people living in the house if a device restarted
4. they don't seem to be translated?

That the enabled modules are printed is okay.

markus2330, 2023-10-15:
Btw. the `🔒 Garage door closed.` is okay to be shown (important enough) but it is also not translated.

Closed 2023-10-20.

Thread 105 (2023-10-15):

error message wrong?

markus2330, 2023-10-15:
Given the configuration:

```
Enabled Modules:
Buttons: true
, Garage: false
, Sensors: false
, ModIR: false
, Environment: true
, Weatherstation: false
, Battery: true
, Watchdog: false
```

I get the error:

```
Error reading buttons of board ENXIO: No such device or address
```

it might be the error from pre0.8 that read like:

```
Fehler beim Lesen der Knöpfe am Board 21....
```

The message read likes as if the board is called ENXIO?
Also translation seems to be missing.

@fel115 did you also see this error already?

fel115, 2023-10-16:
I haven't seen this error so far. With the Buttons, I haven't had problems.
I think there is something broken with the `smbus` connection.

Closed 2023-10-20.

Thread 106 (2023-10-15):

nextcloud user status not updated

markus2330, 2023-10-15:
should be battery and open/close etc. but does not seem to be updated properly

fel115, 2023-10-16:
For some reason, the new states aren't updated. Maybe something is wrong with the `async fn send_status(&self)` function. I get the right status if I check them with the command `\status`. Maybe there is something wrong with the payload. @horenso do you have any idea?

fel115, 2023-10-16:
Now it's working for me. But I don't know what I have changed, I just added an `eprintln` for debugging.

fel115, 2023-10-16:
Okay now I tested it with Env and Garage. It worked and I also have an implementation for the Battery status.
I think the problem was, that a switch from Closed to Open or from Open to Closed needs to be executed to change the state. Or an update from Environment.

markus2330, 2023-10-19:
Is this fixed in #112?

markus2330, 2023-10-19:
#106 doesn't seem to fix the whole problem. Also env status doesn't seem to be set?

fel115, 2023-10-19:
I used the `.deb` file from PR #112 and it updates the status for Env, Bat and Garage.

markus2330, 2023-10-20:
I found in the log would might be the problem here:

```
Okt 19 11:27:48 garage opensesame[13645]: Error: reqwest::Error { kind: Status(503), url: Url { scheme: "https", cannot_be_a_base: false, username: "", password: None, host: Some(Domain("nextcloud.markus-raab.org")), port: None, path: "/nextcloud/ocs/v2.php/apps/spreed/>
Okt 19 11:27:48 garage opensesame[13645]: Error: reqwest::Error { kind: Status(503), url: Url { scheme: "https", cannot_be_a_base: false, username: "", password: None, host: Some(Domain("nextcloud.markus-raab.org")), port: None, path: "/nextcloud/ocs/v2.php/apps/spreed/>
Okt 19 11:27:48 garage opensesame[13645]: Error: reqwest::Error { kind: Status(503), url: Url { scheme: "https", cannot_be_a_base: false, username: "", password: None, host: Some(Domain("nextcloud.markus-raab.org")), port: None, path: "/nextcloud/ocs/v2.php/apps/spreed/>
Okt 19 11:27:49 garage opensesame[13645]: Error: reqwest::Error { kind: Status(503), url: Url { scheme: "https", cannot_be_a_base: false, username: "", password: None, host: Some(Domain("nextcloud.markus-raab.org")), port: None, path: "/nextcloud/ocs/v2.php/apps/spreed/>
Okt 19 11:27:49 garage opensesame[13645]: Error: reqwest::Error { kind: Status(503), url: Url { scheme: "https", cannot_be_a_base: false, username: "", password: None, host: Some(Domain("nextcloud.markus-raab.org")), port: None, path: "/nextcloud/ocs/v2.php/apps/spreed/>
```

Config is `nextcloud.url = "https://nextcloud.markus-raab.org/nextcloud` which works for sending/receiving messages?

fel115, 2023-10-20:
This is my config of nextcloud and the status update works for me.
```toml
nextcloud.user = "<user>"
nextcloud.pass = "<password>"
nextcloud.url = "https://nextcloud.markus-raab.org/nextcloud"
nextcloud.format.datetime = "%d.%m.%Y %H:%M:%S"
nextcloud.format.time = "%H:%M:%S"
```

I tested it again with the new `.deb` from master and it still works for me.

As I see the log is created by sending messages because the path `nextcloud/ocs/v2.php/apps/spreed/api/v1/chat/` is used to send messages, and the path `nextcloud/ocs/v2.php/apps/user_status/api/v1/user_status/message/custom` is for updating the status

markus2330, 2023-10-20:
Ok, thx, then these messages are unrelated.

Thread 110 (2023-10-15):

low battery seems to cause lights to turn on

markus2330, 2023-10-15:
```
💡 Pressed switch outside or light button. Light switched on..
18:52
Haustür
💡 Pressed switch inside. Light switched on..
19:45
🕶️ Light was turned off.
19:48
```

```
🪫 Battery Capacity is below 50% at 42%
19:45
```

At 19:45 no button was pressed.

fel115, 2023-10-16:
Could it be, that the pull-ups don't work at a low capacity?  According to the source code, I can't see a correlation between those events.

markus2330, 2023-10-16:
Yes, I was also astonished. So you mean to use lower values for the pull-ups?

fel115, 2023-10-16:
Yes, I thought, that the 3V Battery doesn't supply the board with 5V, so there could be a problem with the pull-ups which are using the 5V pins. But the Buttons have an external Power supply, so I don't think that the 5V is the reason.

Closed 2023-10-20.

Thread 116 (2023-10-16):

too many requests

markus2330, 2023-10-16:
Maybe simply an error on the server side.

```
Test User
⚠️ Ein Fehler ist beim ausführen der Wetterstation aufgetreten: IO Error: Custom { kind: Other, error: "HTTP status server error (502 Bad Gateway) for url (https://api.opensensemap.org/boxes/64cb602193c69500072a580f/data)" }
11:04
￼
Test User
⚠️ Ein Fehler ist beim ausführen der Wetterstation aufgetreten: IO Error: Custom { kind: Other, error: "HTTP status server error (502 Bad Gateway) for url (https://api.opensensemap.org/boxes/64cb602193c69500072a580f/data)" }
18:28
⚠️ Ein Fehler ist beim ausführen der Wetterstation aufgetreten: IO Error: Custom { kind: Other, error: "HTTP status server error (502 Bad Gateway) for url (https://api.opensensemap.org/boxes/64cb602193c69500072a580f/data)" }
18:28
⚠️ Ein Fehler ist beim ausführen der Wetterstation aufgetreten: IO Error: Custom { kind: Other, error: "HTTP status client error (429 Too Many Requests) for url (https://api.opensensemap.org/boxes/64cb602193c69500072a580f/data)" }
18:28
⚠️ Ein Fehler ist beim ausführen der Wetterstation aufgetreten: IO Error: Custom { kind: Other, error: "HTTP status client error (429 Too Many Requests) for url (https://api.opensensemap.org/boxes/64cb602193c69500072a580f/data)" }
18:28
⚠️ Ein Fehler ist beim ausführen der Wetterstation aufgetreten: IO Error: Custom { kind: Other, error: "HTTP status client error (429 Too Many Requests) for url (https://api.opensensemap.org/boxes/64cb602193c69500072a580f/data)" }
18:28
⚠️ Ein Fehler ist beim ausführen der Wetterstation aufgetreten: IO Error: Custom { kind: Other, error: "HTTP status client error (429 Too Many Requests) for url (https://api.opensensemap.org/boxes/64cb602193c69500072a580f/data)" }
18:28
⚠️ Ein Fehler ist beim ausführen der Wetterstation aufgetreten: IO Error: Custom { kind: Other, error: "HTTP status client error (429 Too Many Requests) for url (https://api.opensensemap.org/boxes/64cb602193c69500072a580f/data)" }
18:28
⚠️ Ein Fehler ist beim ausführen der Wetterstation aufgetreten: IO Error: Custom { kind: Other, error: "HTTP status client error (429 Too Many Requests) for url (https://api.opensensemap.org/boxes/64cb602193c69500072a580f/data)" }
18:28
⚠️ Ein Fehler ist beim ausführen der Wetterstation aufgetreten: IO Error: Custom { kind: Other, error: "HTTP status client error (429 Too Many Requests) for url (https://api.opensensemap.org/boxes/64cb602193c69500072a580f/data)" }
18:28
⚠️ Ein Fehler ist beim ausführen der Wetterstation aufgetreten: IO Error: Custom { kind: Other, error: "HTTP status client error (429 Too Many Requests) for url (https://api.opensensemap.org/boxes/64cb602193c69500072a580f/data)" }
18:28
⚠️ Ein Fehler ist beim ausführen der Wetterstation aufgetreten: IO Error: Custom { kind: Other, error: "HTTP status client error (429 Too Many Requests) for url (https://api.opensensemap.org/boxes/64cb602193c69500072a580f/data)" }
18:28
⚠️ Ein Fehler ist beim ausführen der Wetterstation aufgetreten: IO Error: Custom { kind: Other, error: "HTTP status client error (429 Too Many Requests) for url (https://api.opensensemap.org/boxes/64cb602193c69500072a580f/data)" }
18:28
⚠️ Ein Fehler ist beim ausführen der Wetterstation aufgetreten: IO Error: Custom { kind: Other, error: "HTTP status client error (429 Too Many Requests) for url (https://api.opensensemap.org/boxes/64cb602193c69500072a580f/data)" }
18:29
⚠️ Ein Fehler ist beim ausführen der Wetterstation aufgetreten: IO Error: Custom { kind: Other, error: "HTTP status client error (429 Too Many Requests) for url (https://api.opensensemap.org/boxes/64cb602193c69500072a580f/data)" }
18:29
⚠️ Ein Fehler ist beim ausführen der Wetterstation aufgetreten: IO Error: Custom { kind: Other, error: "HTTP status client error (429 Too Many Requests) for url (https://api.opensensemap.org/boxes/64cb602193c69500072a580f/data)" }
18:29
⚠️ Ein Fehler ist beim ausführen der Wetterstation aufgetreten: IO Error: Custom { kind: Other, error: "HTTP status client error (429 Too Many Requests) for url (https://api.opensensemap.org/boxes/64cb602193c69500072a580f/data)" }
18:29
⚠️ Ein Fehler ist beim ausführen der Wetterstation aufgetreten: IO Error: Custom { kind: Other, error: "HTTP status client error (429 Too Many Requests) for url (https://api.opensensemap.org/boxes/64cb602193c69500072a580f/data)" }
18:29
⚠️ Ein Fehler ist beim ausführen der Wetterstation aufgetreten: IO Error: Custom { kind: Other, error: "HTTP status client error (429 Too Many Requests) for url (https://api.opensensemap.org/boxes/64cb602193c69500072a580f/data)" }
18:29
⚠️ Ein Fehler ist beim ausführen der Wetterstation aufgetreten: IO Error: Custom { kind: Other, error: "HTTP status client error (429 Too Many Requests) for url (https://api.opensensemap.org/boxes/64cb602193c69500072a580f/data)" }
18:29
⚠️ Ein Fehler ist beim ausführen der Wetterstation aufgetreten: IO Error: Custom { kind: Other, error: "HTTP status client error (429 Too Many Requests) for url (https://api.opensensemap.org/boxes/64cb602193c69500072a580f/data)" }
18:29
⚠️ Ein Fehler ist beim ausführen der Wetterstation aufgetreten: IO Error: Custom { kind: Other, error: "HTTP status client error (429 Too Many Requests) for url (https://api.opensensemap.org/boxes/64cb602193c69500072a580f/data)" }
18:29
⚠️ Ein Fehler ist beim ausführen der Wetterstation aufgetreten: IO Error: Custom { kind: Other, error: "HTTP status client error (429 Too Many Requests) for url (https://api.opensensemap.org/boxes/64cb602193c69500072a580f/data)" }
18:29
⚠️ Ein Fehler ist beim ausführen der Wetterstation aufgetreten: IO Error: Custom { kind: Other, error: "HTTP status client error (429 Too Many Requests) for url (https://api.opensensemap.org/boxes/64cb602193c69500072a580f/data)" }
18:29
⚠️ Ein Fehler ist beim ausführen der Wetterstation aufgetreten: IO Error: Custom { kind: Other, error: "HTTP status client error (429 Too Many Requests) for url (https://api.opensensemap.org/boxes/64cb602193c69500072a580f/data)" }
18:29
⚠️ Ein Fehler ist beim ausführen der Wetterstation aufgetreten: IO Error: Custom { kind: Other, error: "HTTP status client error (429 Too Many Requests) for url (https://api.opensensemap.org/boxes/64cb602193c69500072a580f/data)" }
18:29
⚠️ Ein Fehler ist beim ausführen der Wetterstation aufgetreten: IO Error: Custom { kind: Other, error: "HTTP status client error (429 Too Many Requests) for url (https://api.opensensemap.org/boxes/64cb602193c69500072a580f/data)" }
18:29
⚠️ Ein Fehler ist beim ausführen der Wetterstation aufgetreten: IO Error: Custom { kind: Other, error: "HTTP status client error (429 Too Many Requests) for url (https://api.opensensemap.org/boxes/64cb602193c69500072a580f/data)" }
18:29
⚠️ Ein Fehler ist beim ausführen der Wetterstation aufgetreten: IO Error: Custom { kind: Other, error: "HTTP status client error (429 Too Many Requests) for url (https://api.opensensemap.org/boxes/64cb602193c69500072a580f/data)" }
18:29
⚠️ Ein Fehler ist beim ausführen der Wetterstation aufgetreten: IO Error: Custom { kind: Other, error: "HTTP status client error (429 Too Many Requests) for url (https://api.opensensemap.org/boxes/64cb602193c69500072a580f/data)" }
18:29
⚠️ Ein Fehler ist beim ausführen der Wetterstation aufgetreten: IO Error: Custom { kind: Other, error: "HTTP status client error (429 Too Many Requests) for url (https://api.opensensemap.org/boxes/64cb602193c69500072a580f/data)" }
18:29
⚠️ Ein Fehler ist beim ausführen der Wetterstation aufgetreten: IO Error: Custom { kind: Other, error: "HTTP status client error (429 Too Many Requests) for url (https://api.opensensemap.org/boxes/64cb602193c69500072a580f/data)" }
18:29
⚠️ Ein Fehler ist beim ausführen der Wetterstation aufgetreten: IO Error: Custom { kind: Other, error: "HTTP status client error (429 Too Many Requests) for url (https://api.opensensemap.org/boxes/64cb602193c69500072a580f/data)" }
18:29
⚠️ Ein Fehler ist beim ausführen der Wetterstation aufgetreten: IO Error: Custom { kind: Other, error: "HTTP status client error (429 Too Many Requests) for url (https://api.opensensemap.org/boxes/64cb602193c69500072a580f/data)" }
18:29
⚠️ Ein Fehler ist beim ausführen der Wetterstation aufgetreten: IO Error: Custom { kind: Other, error: "HTTP status client error (429 Too Many Requests) for url (https://api.opensensemap.org/boxes/64cb602193c69500072a580f/data)" }
18:30
⚠️ Ein Fehler ist beim ausführen der Wetterstation aufgetreten: IO Error: Custom { kind: Other, error: "HTTP status client error (429 Too Many Requests) for url (https://api.opensensemap.org/boxes/64cb602193c69500072a580f/data)" }
18:30
⚠️ Ein Fehler ist beim ausführen der Wetterstation aufgetreten: IO Error: Custom { kind: Other, error: "HTTP status client error (429 Too Many Requests) for url (https://api.opensensemap.org/boxes/64cb602193c69500072a580f/data)" }
18:30
⚠️ Ein Fehler ist beim ausführen der Wetterstation aufgetreten: IO Error: Custom { kind: Other, error: "HTTP status client error (429 Too Many Requests) for url (https://api.opensensemap.org/boxes/64cb602193c69500072a580f/data)" }
18:30
⚠️ Ein Fehler ist beim ausführen der Wetterstation aufgetreten: IO Error: Custom { kind: Other, error: "HTTP status client error (429 Too Many Requests) for url (https://api.opensensemap.org/boxes/64cb602193c69500072a580f/data)" }
18:30
⚠️ Ein Fehler ist beim ausführen der Wetterstation aufgetreten: IO Error: Custom { kind: Other, error: "HTTP status client error (429 Too Many Requests) for url (https://api.opensensemap.org/boxes/64cb602193c69500072a580f/data)" }
18:30
⚠️ Ein Fehler ist beim ausführen der Wetterstation aufgetreten: IO Error: Custom { kind: Other, error: "HTTP status client error (429 Too Many Requests) for url (https://api.opensensemap.org/boxes/64cb602193c69500072a580f/data)" }
18:30
⚠️ Ein Fehler ist beim ausführen der Wetterstation aufgetreten: IO Error: Custom { kind: Other, error: "HTTP status client error (429 Too Many Requests) for url (https://api.opensensemap.org/boxes/64cb602193c69500072a580f/data)" }
18:30
⚠️ Ein Fehler ist beim ausführen der Wetterstation aufgetreten: IO Error: Custom { kind: Other, error: "HTTP status client error (429 Too Many Requests) for url (https://api.opensensemap.org/boxes/64cb602193c69500072a580f/data)" }
18:30
⚠️ Ein Fehler ist beim ausführen der Wetterstation aufgetreten: IO Error: Custom { kind: Other, error: "HTTP status client error (429 Too Many Requests) for url (https://api.opensensemap.org/boxes/64cb602193c69500072a580f/data)" }
18:30
⚠️ Ein Fehler ist beim ausführen der Wetterstation aufgetreten: IO Error: Custom { kind: Other, error: "HTTP status client error (429 Too Many Requests) for url (https://api.opensensemap.org/boxes/64cb602193c69500072a580f/data)" }
18:30
⚠️ Ein Fehler ist beim ausführen der Wetterstation aufgetreten: IO Error: Custom { kind: Other, error: "HTTP status client error (429 Too Many Requests) for url (https://api.opensensemap.org/boxes/64cb602193c69500072a580f/data)" }
18:30
⚠️ Ein Fehler ist beim ausführen der Wetterstation aufgetreten: IO Error: Custom { kind: Other, error: "HTTP status client error (429 Too Many Requests) for url (https://api.opensensemap.org/boxes/64cb602193c69500072a580f/data)" }
18:30
⚠️ Ein Fehler ist beim ausführen der Wetterstation aufgetreten: IO Error: Custom { kind: Other, error: "HTTP status client error (429 Too Many Requests) for url (https://api.opensensemap.org/boxes/64cb602193c69500072a580f/data)" }
18:30
⚠️ Ein Fehler ist beim ausführen der Wetterstation aufgetreten: IO Error: Custom { kind: Other, error: "HTTP status client error (429 Too Many Requests) for url (https://api.opensensemap.org/boxes/64cb602193c69500072a580f/data)" }
```

fel115, 2023-10-16:
How is the data.interval configured? Maybe it is too short?

markus2330, 2023-10-19:
`data.interval` does not seem to be specified in files/opensesame.spec
Do we really need this setting? I think we should hardcode it, as it is fixed by opensensemap anyway?

Reading from the TOML file: `data.interval` is 60.

fel115, 2023-10-19:
Oh, we forgot to add `weatherstation.data.interval` to the `opensesame.spec`. If we would like to code the interval hard, this can be easily done by changing the following line in code:
https://github.com/ElektraInitiative/opensesame/blob/9dfe89c53382e3422059b3bd001972b698d69901/src/main.rs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

markus2330, 2023-10-19:
Yes, please simply hardcode, no need to have this configurable. Please also check for other config options you might have introduced. You can fix all the remaining issues you have open in #112

fel115, 2023-10-19:
I hard-coded the one-minute interval in #112.  Hopefully the error `Too Many Requests` is now removed.

markus2330, 2023-10-20:
Thx, I'll close this then.

markus2330, 2023-11-01:
No, it still happens from time to time. Same pattern: A few 502 Bad Gateway, and then  429 Too Many Requests.

But I think the problem is upstream.

Closed 2023-12-04.

Thread 117 (2023-10-19):

implement simple alarm via chat

markus2330, 2023-10-19:
Alarm messages sent to NC should be read as alarm commands of other devices participating in this chat.

E.g. with devices A,B,C, device A sends: `🚨 Feueralarm! Feueralarm! FEUERALARM! ⏰. {}` and additionally `/alarm fire`, the devices B and C receive this as command to also execute the (fire) alarm (bell or audio bell).

Thread 120 (2023-10-19):

ssh commands broken

markus2330, 2023-10-19:
```
Couldn't send SIGUSR2 to other opensesame instance: Unable to load key, bad format or passphrase: Unsupported key type ssh-rsa
```

Probably we should simply remove the ssh commands and use #117 instead?

@fel115 or did it work for you?

fel115, 2023-10-19:
I never tested the SSH connection, but I think the idea over the Commands Chat sounds really promising. So there could be also other boards outside of the LAN that can be notified about an alarm.

Thread 123 (2023-10-20):

mdbook warnings

markus2330, 2023-10-20:
`mdbook test` fails:

```
running 3 tests
test /tmp/mdbook-QDmle0/Debugging.md - Debugging::Trigger_Watchdog (line 21) ... FAILED
test /tmp/mdbook-QDmle0/Debugging.md - Debugging::Corrupt_History_File (line 43) ... FAILED
test /tmp/mdbook-QDmle0/Debugging.md - Debugging::Trigger_Watchdog (line 30) ... FAILED

failures:

---- /tmp/mdbook-QDmle0/Debugging.md - Debugging::Trigger_Watchdog (line 21) stdout ----
error: unknown start of token: \
 --> /tmp/mdbook-QDmle0/Debugging.md:22:25
  |
3 | ssh olimex@haustuer cat \| sudo --prompt="" -S -- tee /dev/watchdog << EOF
  |                         ^

error: expected one of `!`, `.`, `::`, `;`, `?`, `{`, `}`, or an operator, found `olimex`
 --> /tmp/mdbook-QDmle0/Debugging.md:22:5
  |
3 | ssh olimex@haustuer cat \| sudo --prompt="" -S -- tee /dev/watchdog << EOF
  |     ^^^^^^ expected one of 8 possible tokens

error: aborting due to 2 previous errors

Couldn't compile the test.
---- /tmp/mdbook-QDmle0/Debugging.md - Debugging::Corrupt_History_File (line 43) stdout ----
error: expected expression, found `.`
 --> /tmp/mdbook-QDmle0/Debugging.md:44:70
  |
3 | mv .zsh_history .zsh_history.broken && strings .zsh_history.broken > .zsh_history && fc -R .zsh_history
  |                                                                      ^ expected expression

error: aborting due to previous error

Couldn't compile the test.
---- /tmp/mdbook-QDmle0/Debugging.md - Debugging::Trigger_Watchdog (line 30) stdout ----
error: unknown start of token: \
 --> /tmp/mdbook-QDmle0/Debugging.md:31:25
  |
3 | ssh olimex@haustuer cat \| sudo --prompt="" -S -- "sh -c 'killall -9 opensesame && tee /dev/watchdog'"  << EOF
  |                         ^

error: expected one of `!`, `.`, `::`, `;`, `?`, `{`, `}`, or an operator, found `olimex`
 --> /tmp/mdbook-QDmle0/Debugging.md:31:5
  |
3 | ssh olimex@haustuer cat \| sudo --prompt="" -S -- "sh -c 'killall -9 opensesame && tee /dev/watchdog'"  << EOF
  |     ^^^^^^ expected one of 8 possible tokens

error: aborting due to 2 previous errors

Couldn't compile the test.

failures:
    /tmp/mdbook-QDmle0/Debugging.md - Debugging::Corrupt_History_File (line 43)
    /tmp/mdbook-QDmle0/Debugging.md - Debugging::Trigger_Watchdog (line 21)
    /tmp/mdbook-QDmle0/Debugging.md - Debugging::Trigger_Watchdog (line 30)

test result: FAILED. 0 passed; 3 failed; 0 ignored; 0 measured; 0 filtered out; finished in 0.02s

--- stderr

2023-10-20 07:41:28 [INFO] (mdbook::book): Testing chapter 'Troubles libmodbus': "libmodbus-troubles.md"
2023-10-20 07:41:28 [INFO] (mdbook::book): Testing chapter 'Troubleshooting': "Troubleshooting.md"
2023-10-20 07:41:28 [ERROR] (mdbook::book): rustdoc returned an error:

--- stdout

running 1 test
test /tmp/mdbook-QDmle0/Troubleshooting.md - Troubleshooting::DevelopmentSetup::___If_you_get_an_error_with_ (line 41) ... FAILED

failures:

---- /tmp/mdbook-QDmle0/Troubleshooting.md - Troubleshooting::DevelopmentSetup::___If_you_get_an_error_with_ (line 41) stdout ----
error: expected one of `!`, `.`, `::`, `;`, `?`, `{`, `}`, or an operator, found `debian`
 --> /tmp/mdbook-QDmle0/Troubleshooting.md:42:4
  |
3 | cd debian/ && ./postinst
  |    ^^^^^^ expected one of 8 possible tokens

error: aborting due to previous error

Couldn't compile the test.

failures:
    /tmp/mdbook-QDmle0/Troubleshooting.md - Troubleshooting::DevelopmentSetup::___If_you_get_an_error_with_ (line 41)

test result: FAILED. 0 passed; 1 failed; 0 ignored; 0 measured; 0 filtered out; finished in 0.02s

--- stderr

2023-10-20 07:41:28 [INFO] (mdbook::book): Testing chapter 'Ansible': "Ansible.md"
2023-10-20 07:41:28 [INFO] (mdbook::book): Testing chapter 'Installation': "Install.md"
2023-10-20 07:41:28 [INFO] (mdbook::book): Testing chapter 'Modules Overview': "Modules_Overview.md"
2023-10-20 07:41:28 [INFO] (mdbook::book): Testing chapter 'GPIO': "GPIO.md"
2023-10-20 07:41:28 [INFO] (mdbook::book): Testing chapter 'I2C': "I2C.md"
2023-10-20 07:41:28 [INFO] (mdbook::book): Testing chapter 'MQ135': "MQ135.md"
2023-10-20 07:41:28 [ERROR] (mdbook::book): rustdoc returned an error:

--- stdout

running 1 test
test /tmp/mdbook-QDmle0/MQ135.md - SNS_MQ135 (line 35) ... FAILED

failures:

---- /tmp/mdbook-QDmle0/MQ135.md - SNS_MQ135 (line 35) stdout ----
error: unknown start of token: \u{2013}
 --> /tmp/mdbook-QDmle0/MQ135.md:36:8
  |
3 | 400ppm – 750ppm: Good for health
  |        ^
  |
help: Unicode character '–' (En Dash) looks like '-' (Minus/Hyphen), but it is not
  |
3 | 400ppm - 750ppm: Good for health
  |        ~

error: unknown start of token: \u{2013}
 --> /tmp/mdbook-QDmle0/MQ135.md:37:9
  |
4 | 750 ppm – 1200 ppm: Take care
  |         ^
  |
help: Unicode character '–' (En Dash) looks like '-' (Minus/Hyphen), but it is not
  |
4 | 750 ppm - 1200 ppm: Take care
  |         ~

error: unknown start of token: \u{b3}
 --> /tmp/mdbook-QDmle0/MQ135.md:38:40
  |
5 | 1200 ppm (and above): Harmful to health³
  |                                        ^

error: expected one of `!`, `(`, `.`, `::`, `;`, `<`, `?`, or `}`, found keyword `for`
 --> /tmp/mdbook-QDmle0/MQ135.md:36:23
  |
3 | 400ppm – 750ppm: Good for health
  |                -      ^^^ expected one of 8 possible tokens
  |                |
  |                tried to parse a type due to this

error: aborting due to 4 previous errors

Couldn't compile the test.

failures:
    /tmp/mdbook-QDmle0/MQ135.md - SNS_MQ135 (line 35)

test result: FAILED. 0 passed; 1 failed; 0 ignored; 0 measured; 0 filtered out; finished in 0.02
```

Thread 126 (2023-10-26):

lights as module

markus2330, 2023-10-26:
Hi,

what I actually wanted to change is the delay between switching on the different lights (if they are switched too fast, it creates electrical disturbance).

I stumbled upon handle_wrong_input, which I did not really understand, a comment there would be needed.

Looking further, I saw that the main logic for the buttons is now very nice&clear but the lights (and bell) logic is still in the old non-async way (which is very hard to read). So I was thinking that it probably makes more sense to rewrite that code to an extra async lights module, similar to how Garage works, which will maybe also let us get rid of hacks like handle_wrong_input?

Having a lights/enable would be a nice side-effect, as probably not every installation has lights at every entrance? @fel115 how about your situation? Can you maybe help out here?

fel115, 2023-10-28:
> I stumbled upon handle_wrong_input, which I did not really understand, a comment there would be needed.

I think the handle_wrong_input sets the buttons LEDs, if the input pin is wrong or a input timeout occurs.

> Looking further, I saw that the main logic for the buttons is now very nice&clear but the lights (and bell) logic is still in the old non-async way (which is very hard to read). So I was thinking that it probably makes more sense to rewrite that code to an extra async lights module, similar to how Garage works, which will maybe also let us get rid of hacks like handle_wrong_input?

Yes, the idea was to do the reflector to async and then take a closer look into the modules, to remove non-async operations.

> Having a lights/enable would be a nice side-effect, as probably not every installation has lights at every entrance? @fel115 how about your situation? Can you maybe help out here?

Yes I thinks so.

Thread 127 (2023-10-29):

invalid panic

markus2330, 2023-10-29:
Seems like we still have panics within code where it definitely shouldn't happen:

`Okt 29 09:00:14 haustuer opensesame[19024]: thread 'tokio-runtime-worker' panicked at 'I2C Communication to Buttons does not work: Nix(EIO)', src/buttons.rs:170:14`

Expected behavior:
retry and/or reboot (watchdog)

Actual behavior:
system unresponsive (you cannot open the door anymore)

Thread 133 (2024-01-07):

panic in conv_vec_to_value_u

markus2330, 2024-01-07:
Maybe on too strong wind or too cold?

```
Jän 06 11:31:59 messstation opensesame[13532]: thread 'tokio-runtime-worker' panicked at 'called `Result::unwrap()` on an `Err` value: ()', /home/jenkins/workspace/opensesame_fixes/src/clima_sensor_us.rs:255:72
Jän 06 11:31:59 messstation opensesame[13532]: note: run with `RUST_BACKTRACE=1` environment variable to display a backtrace
```

@fel115 do you have an idea what this could be? Any progress on the blog for Olimex?

fel115, 2024-01-08:
Yes, it seems that in [line 249](https://github.com/ElektraInitiative/opensesame/blob/177e14fd1ad29c04c1a838fc01f01b43150c5eae/src/clima_sensor_us.rs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)  the value of the clima sensor is `0xFFFFFFFF` which is the error code for unsigned 32. So before using the `Air Temp` and `Mean Wind Speed` values we need to check if the `conv_vec_to_value_s` or `conv_vec_to_value_s` have any error.

```rust
match conv_vec_to_value_s((response_temp[0], response_temp[1]) {
    Ok(value) => {temp = value as 32 / 10.0;},
    Err(_) => ()
}

match conv_vec_to_value_u((response_wind[0], response_wind[1]) {
    Ok(value) => {wind = value as 32 / 10.0;},
    Err(_) => ()
}
```

According to the blog for Olimex, I will try to finish that in February.

markus2330, 2024-01-08:
Thx for looking into it and creating the PR!

> According to the blog for Olimex, I will try to finish that in February.

Sounds like a plan. :rocket:
