ElektraInitiative/opensesame/src/lib.rs

pub mod audio;
pub mod bat;
pub mod buttons;
pub mod clima_sensor_us;
pub mod config;
pub mod environment;
pub mod garage;
pub mod mod_ir_temp;
pub mod nextcloud;
pub mod ping;
pub mod pwr;
pub mod sensors;
pub mod signals;
pub mod ssh;
pub mod types;
pub mod validator;
pub mod watchdog;
