ElektraInitiative/opensesame/src/ssh.rs

use async_ssh2_tokio::*;

const SSH_HOST_IP: &str = "192.168.178.53";

pub async fn exec_ssh_command(command: String) -> Result<(), Error> {
	let auth_method = AuthMethod::PrivateKeyFile {
		key_file_name: String::from("/home/olimex/.ssh/id_rsa"),
		key_pass: None,
	};
	let client = Client::connect(
		(SSH_HOST_IP, 22),
		"olimex",
		auth_method,
		ServerCheckMethod::NoCheck,
	)
	.await?;
	client.execute(&command).await?;
	Ok(())
}
