ElektraInitiative/opensesame/(commit log)

2022-10-04 add pin.jpg
2022-11-11 environment: avoid non-translated text
    [environment.rs]
2022-11-11 set status message to ON at startup
    this was a bug:
    it could be a long time without air quality changes
    then devices would wrongly show they are off
    also fixes:
    - 2 other outdated translations
    - the description how to do translations
    [main.rs]
2022-11-11 also switch on light innen on extensions
    if light was burning outside and you press button inside
    [buttons.rs]
2022-11-11 switch lights depending on sunrise/sunset
    currently hardcoded with Vienna
2022-11-16 better messages on first I2C msg
2022-11-16 switch pwr off on exceptions
2022-11-16 pwr: also switch off on panics
2022-11-16 fix order: pwr must be first
    [main.rs]
2023-03-05 battery+update translations
2023-03-05 v0.7.2 pump
2023-03-05 make reset logic only at bootup
    avoids Error { kind: Ioctl { kind: LineHandle, cause: EBUSY } }
    at shutdown
    [main.rs, pwr.rs]
2023-03-09 fix translation errors ￼ Ein unbehebbarer Fehler ist bei src/main.rs:542: Argument count has to match number of format directives ({}) passiert
2023-04-12 msg fix and allow environment to be /dev/null
    [environment.rs, main.rs]
2023-06-06 start with spec for sensors
2023-06-07 add i2c_2_clock_freq_overlay.dtbo
    created by @fel115
2023-06-07 update i2c_2_clock_freq_overlay.dtbo and add i2c_2_overlay.dts
2023-07-06 add wiring doc to thiesclima-weatherstation.md
2023-07-17 changing Cargo.toml and doc/I2C.md
2023-07-18 Fingerprints false
2023-07-27 pump version, small updates
2023-08-09 Sanity stage + parallel clippy & test
2023-08-11 switch assignee
2023-08-14 remove Sensor IDs
2023-08-15 environment.rs check for ccs811 module and disable on error
    [environment.rs]
2023-08-18 correction of typos in clima_sensor_us.rs
    [clima_sensor_us.rs]
2023-08-18 Update Opensensemap.md, details about adding sensors
2023-08-18 sending clima sensor errors to ping chat
    [main.rs]
2023-08-18 remove write! error to data.log; fix cargo fmt
    [clima_sensor_us.rs, main.rs]
2023-08-18 changed error handlinbg to calling function
    @horenso pls review the changed parts, I thnik now everything should be changed. Thanks for reviewing :+1:
    [clima_sensor_us.rs, main.rs]
2023-08-21 changed Cargo.toml to use elektra 0.11.0 + libmodbus-rs master; clima_sensor_us.rs impl of const and default function; main.rs handle errors via nc
    [clima_sensor_us.rs, main.rs]
2023-08-25 reset read_counter in handle()
    [mod_ir_temp.rs]
2023-08-28 Add scripts to emulate device.
2023-09-01 Changes in env_loop, weatherstation_loop, modir_loop, sensors_loop; in CommandToButtons; and mod_ir_temps.rs and clima_sensor_us.rs remove timeouts
2023-09-05 Buttons+Validator, Garage, Sensors, ModIR, Env, Nextcloud working
2023-09-10 Move env, garage, sensor and bar loops into their files.
2023-09-13 created signals + ping; Added new command to buttons
    wait for play_audio and env&signals need to use Mutex of state
2023-09-14 remove debug line form Sensors; add Testreport
2023-09-15 Make button use audio sender to play audio file.
2023-09-18 env implementation of mutex(remember/restore-baseline); sensor impl set alarm
2023-09-27 Implementation of Issue #87
    [buttons.rs, clima_sensor_us.rs, environment.rs, garage.rs, main.rs, mod_ir_temp.rs, nextcloud.rs, ping.rs]
2023-09-27 changes in button.rs to handle do_reset; update bat.rs to only trigger check if capacity changed; reorder interval.tick()
2023-10-07 fixing issue #84, setting changes permanent
    [write_to_reg.rs]
2023-10-12 remove prints
2023-10-16 added Ping module to information output; added Status for Battery
2023-10-19 removed Battery on startup, added Translation; bugfix in Garage output
    [bat.rs, garage.rs, main.rs, nextcloud.rs, signals.rs]
2023-10-19 pumped version; edited lang; rev changes in signals
2023-10-20 version pump
2023-12-04 pump version
2023-12-04 simplify error logic+improve error text
    [buttons.rs]
2023-12-05 try to fix #41
    Timeout mit Sequenz [0, 15, 0, 15, 0, 15]
    [buttons.rs]
2024-01-08 fix max wind bug in clima_sensor_us.rs
    [clima_sensor_us.rs]
